ThorOdin20/Sinusoidal-and-Rectangular-Function-Generator/README.md

# Sinusoidal-and-Rectangular-Function-Generator
I implemented a rectangular and triangular oscillator by using a cascade connection of an “Integrator” and a Schmitt trigger circuit. The output of the “Integrator” will become the input of the triangle to sine converter by using a changeable slope mechanism.
