ThorOdin20/Sinusoidal-and-Rectangular-Function-Generator/Final Project/Final_Project.asc

C: cap; 68n
D1: diode; 1N4148
D2: diode; 1N4148
D3: diode; 1N4148
D4: diode; 1N4148
D5: diode; 1N4148
D6: diode; 1N4148
Q1: npn; 2N2222
Q2: npn; 2N2222
Q3: pnp; 2N2907
Q4: pnp; 2N2907
R01: res; 10k
R1: res; 665
R2: res; 4.02k
R03: res; 4.44k
R3: res; 40k
R4: res; 15k
R5: res; 22k
R6: res; 5k
R7: res; 8.66k
R8: res; 20
R9: res; 20
R11: res; 510k
R22: res; 73.2k
R33: res; 7.06k
R44: res; 510k
R55: res; 73.2k
R66: res; 7.06k
Rr0: res; 8k
Rr1: res; 28.7k
Rr2: res; 10.2k
Rr3: res; 1.33k
Rr4: res; 28.7k
Rr5: res; 10.2k
Rr6: res; 1.33k
U1: OP37
U2: OP37
U3: pot; Rtot=1k wiper=0
U4: pot; Rtot=10K wiper=0
U5: OP37
U6: OP37
U7: OP27
V1: voltage; 12
V2: voltage; -12
Named nets: 0, V+, V-, RECTANGULAR, SINUS
.tran 0 0.5m 0 0.5u
.ic V(N002)=0.1V
.include pot.sub.
.step param freq .0001 1k 0.1k
.meas tran t1 V(sinus) when V(sinus)=0 rise=2
.meas tran t2 V(sinus) when V(sinus)=0 rise =3
.meas f param 1/(t2-t1)
.step param amp 0 1 0.1
.meas tran amplitude max V(rectangular)
